BlackBrix/DIY-Reflow-Oven-w-Nextion/README.md

this project was 'forked' / copied from here:  
https://www.instructables.com/DIY-REFLOW-OVEN/  
  
created by 'Vulcaman' (© Christian Rostek)  
https://www.instructables.com/member/Vulcaman/  
www.vulcaman.de (including online shop)   
https://www.instagram.com/vulcaman/  
  
find more about Nextion intelligent HMI displays: https://nextion.tech  

see as well this forked project: -> https://github.com/polihedron/DIY-Reflow-Oven  
  
provided as 'open source' under the creative commons license:  
'Attribution-NonCommercial-ShareAlike 4.0 International (CC BY-NC-SA 4.0)'  
  

# non-commercial use !  
    
Original text as follows:

----

# DIY Reflow Oven

<p>

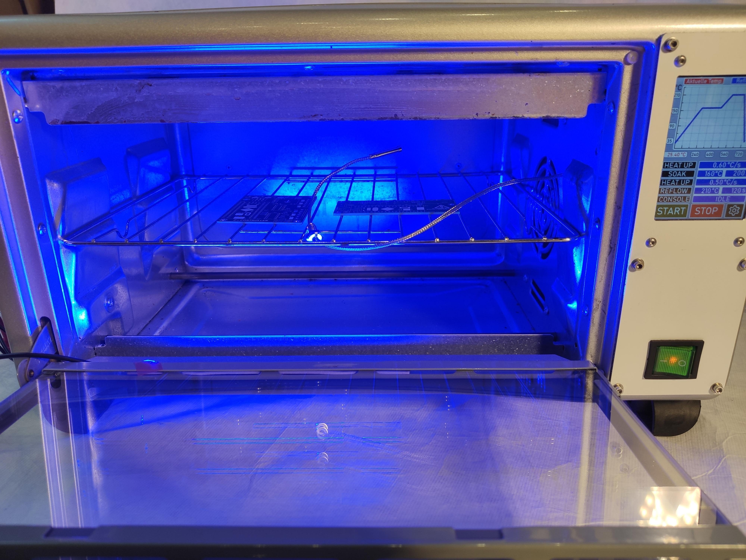
[picture p1: pics/reflow_2.jpg]

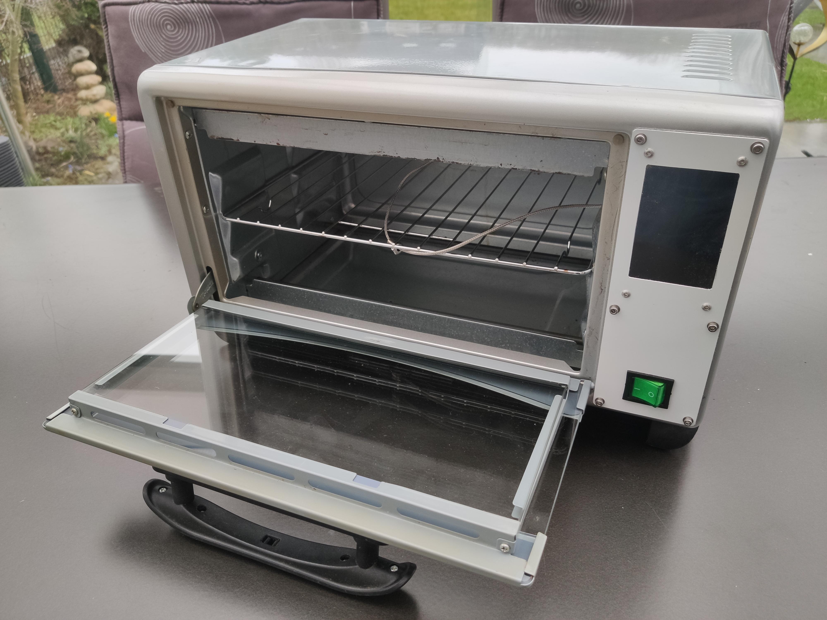
[picture p2: pics/reflow_3.jpg]

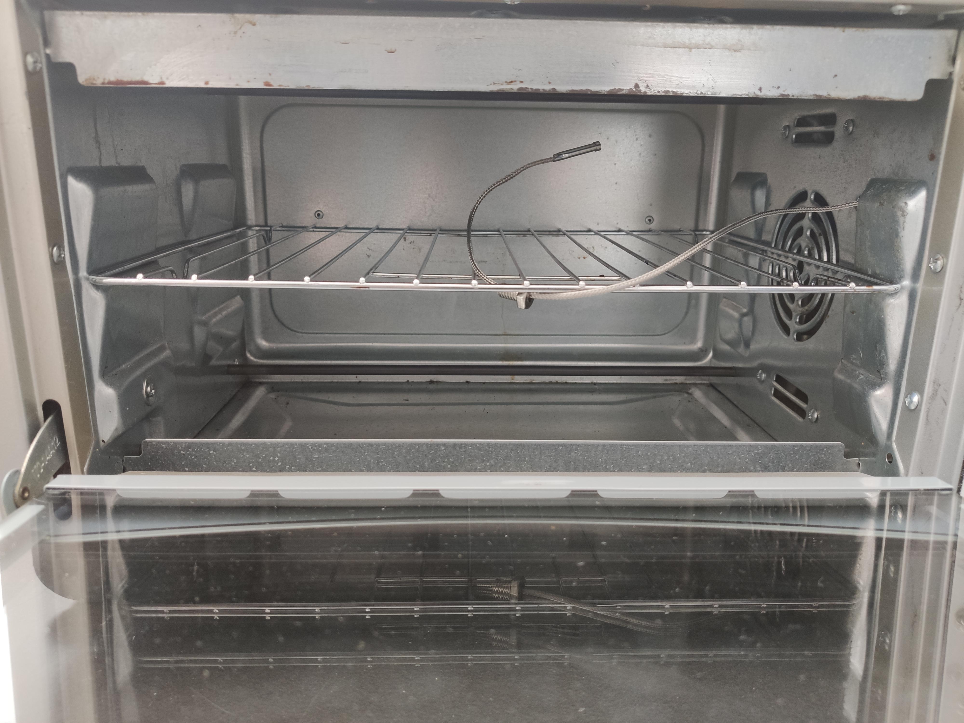
[picture p3: pics/reflow_4.jpg]

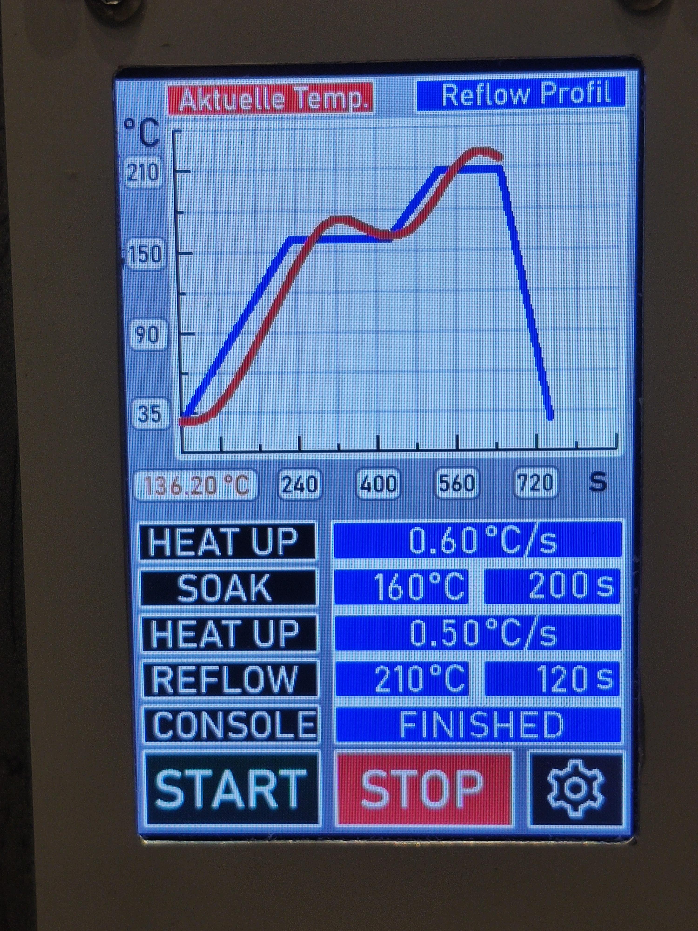
[picture p4: pics/reflow_5.jpg]


</p>

----

<div class="step-body"><p>In this Instructable I want to show you how you can build your own SMD Reflow Oven for under 60€.</p><p>For a few month now, I decided to getting deeper in electronics und PCB-Design. However many SMD components you can buy are so tiny that they are really hard to solder. In the Industry, the standart is an Oven with a predefined Temperature Curve, a so called Reflow-Oven. However a Industrial grade Reflow Oven is really Expensive, so I have searched the Web and I saw a lot of People converting an old Pizza-Oven to a Reflow-Oven. Sadly I couldn't find one which will look that professional I would like. So I started to build my own reflow oven and decided to make it Open Source :-)</p><p>The reflow oven has the followings features:</p><ul><li>1200 W of Power </li><li>Touch Screen </li><li>Modern GUI with Temperature Curve, Keypad and Parameters </li><li>Permanent storage of the settings (Stored in Flash) </li><li>STM32 Microcontroller (Blue Pill) </li><li>PID Temperature Controller </li><li>Overall Cost +-60€</li></ul>

<p><u><strong>Videos of the Reflow Oven<br></strong></u></p>
<ul><li>https://youtu.be/BAKA0E_wQRk</li>
<li>https://youtu.be/CvY7zXQO4RU</li></ul>

<p>If you like my Instructable, please vote for me in the <a href="https://www.instructables.com/contest/automation2021/">Automation Contest</a></p><p>Visit my <a href="https://www.instagram.com/vulcaman/" rel="nofollow noopener">Instagram</a></p><p>Visit my <a href="https://www.vulcaman.de/" rel="nofollow noopener">Website<br></a></p>

<p><strong><u>UPDATE:<br></u></strong></p><p><strong>[27.03.2021] (V1.1) Fixed Integral Wind-Up in PID Controller, Actual Temp will draw longer now<br></strong></p><p><strong>--&gt; Updated STM32 Source Files</strong><br></p></div>

---

## Step 1: Required Parts

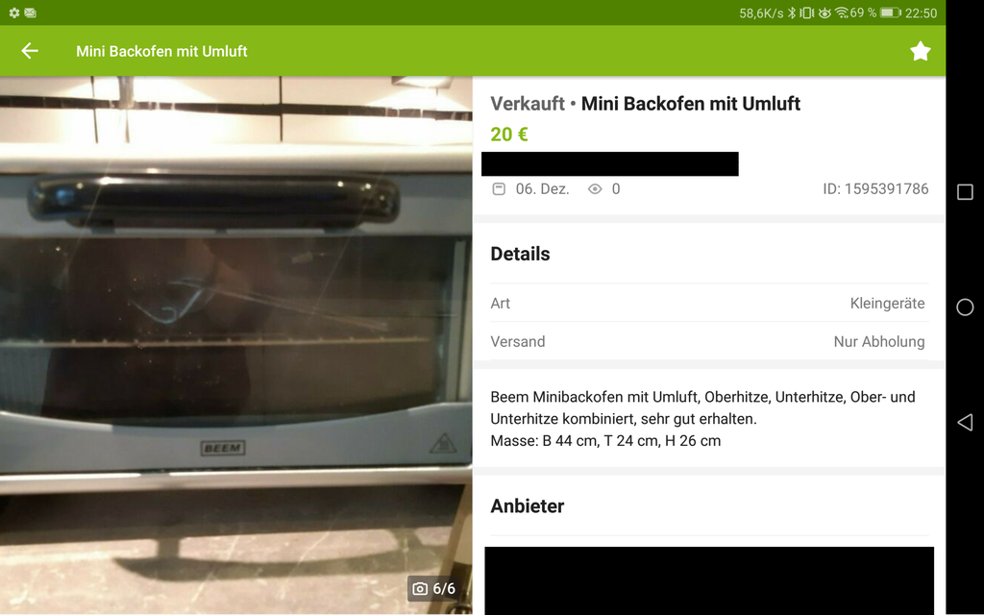
[picture p5: pics/Step_1_1.webp]
<div class="step-body"><p><strong><u>The Base<br></u></strong></p><p>For base the of the reflow oven you will need a cheap Pizza Oven, the more power, the better is oven is suited for an reflow oven, also an integrated ventilator is a plus point. I have found a used one on Ebay Kleinanzeigen for 20€ in my neighborhood which fits perfectly: </p><p></p><p>¨NBSP;</p><p><strong><u>Electronic Parts:<br></u></strong></p><p>Here are all the requierd components, for the reflow oven</p><table style="width: 100.0%;" border="2"><tbody><tr><th>Quantity</th><th>Description</th><th>Link</th><th>Price</th></tr><tr><td>1x</td><td>Nextion Display 3.5" Basic Version<br></td><td><a href="https://de.aliexpress.com/item/4001240732911.html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,searchweb201602_,searchweb201603_" rel="nofollow noopener">Aliexpress</a></td><td>25,32 €<br></td></tr><tr><td>1x</td><td>STM32F103C8T6 "Blue Pill"<br></td><td><a href="https://s.click.aliexpress.com/e/_AfFGsk" rel="nofollow noopener">Aliexpress</a></td><td>2,75 €</td></tr><tr><td>1x</td><td>MAX6675 Thermocouple Modul<br></td><td><a href="https://s.click.aliexpress.com/e/_ApxobS" rel="nofollow noopener">Aliexpress</a></td><td>2,28 €<br></td></tr><tr><td>1x</td><td>Level-Shifter 3.3V to 5V<br></td><td><a href="https://s.click.aliexpress.com/e/_AFqBnW" rel="nofollow noopener">Aliexpress</a></td><td>3,01€ for 10pcs<br></td></tr><tr><td>1x</td><td>5V Powersupply <br></td><td><a href="https://s.click.aliexpress.com/e/_AUP3rQ" rel="nofollow noopener">Aliexpress</a></td><td>1,40€<br></td></tr><tr><td>1x</td><td>SSR Relay 25A<br></td><td><a href="https://s.click.aliexpress.com/e/_ABwoOg" rel="nofollow noopener">Aliexpress</a></td><td>2,93€ <br></td></tr><tr><td>1x</td><td>Main Switch Green<br></td><td><a href="https://s.click.aliexpress.com/e/_9vae84" rel="nofollow noopener">Aliexpress</a></td><td>0,9€<br></td></tr><tr><td>some</td><td>Terminals and Pinheaders<br></td><td><br></td><td><br></td></tr><tr><td>some</td><td>Wires<br></td><td><br></td><td><br></td></tr></tbody></table><p><strong><u><br></u></strong></p><p><strong><u>Mechanical Parts:<br></u></strong></p><p>You will need some screws to mount the display and the front panel<strong><u><br></u></strong></p><table style="width: 100.0%;" border="2"><tbody><tr><th>Quantity</th><th>Description</th><th>Link<br></th></tr><tr><td>10x</td><td><p>M3x16mm DIN912 </p></td><td>local hardware store<br></td></tr><tr><td>some</td><td><p>M3 Hex Nut </p></td><td>local hardware store<br></td></tr><tr><td>1x</td><td><p>Sheet of Alu-Dibond / Aluminium for the Frontpanel</p></td><td>local hardware store<br></td></tr></tbody></table><p><strong><u><br></u></strong></p></div>

---

## Step 2: Remove All the Electronics From the Oven

<p>
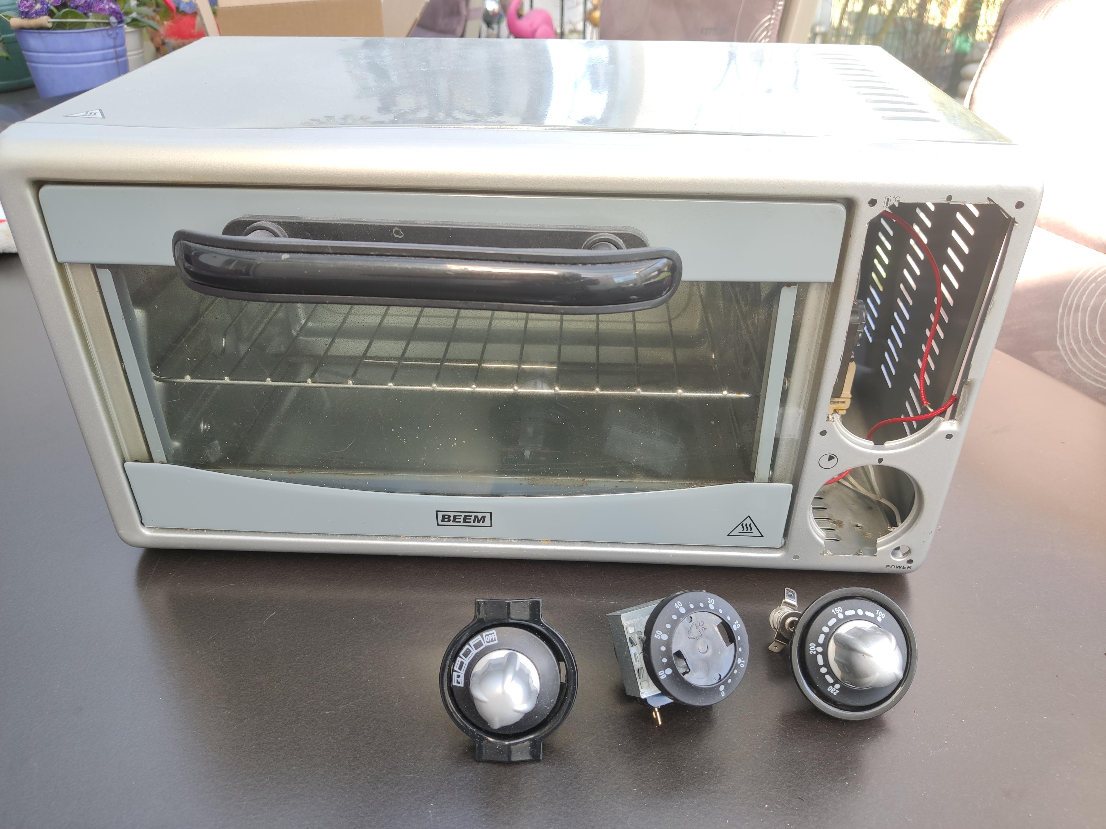
[picture p6: pics/Step2_1.jpg]

</p>

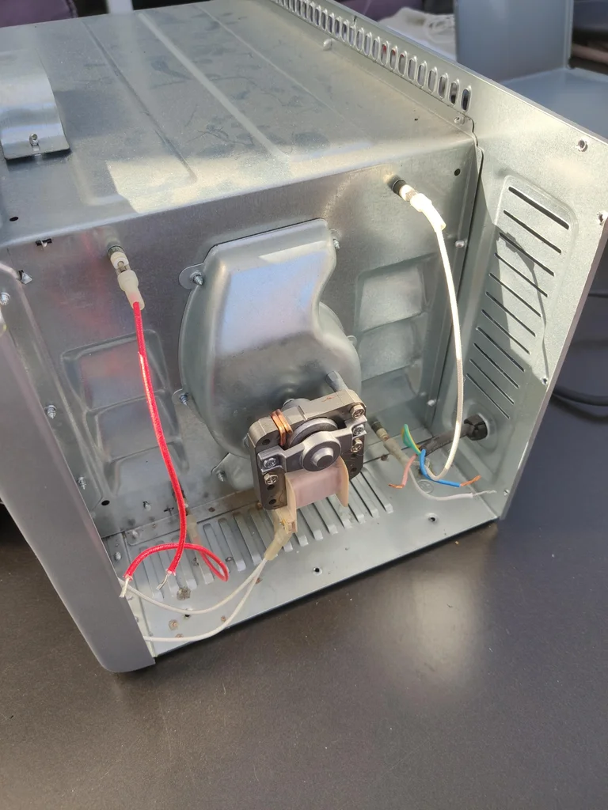
[picture p7: pics/Step2_2.webp]
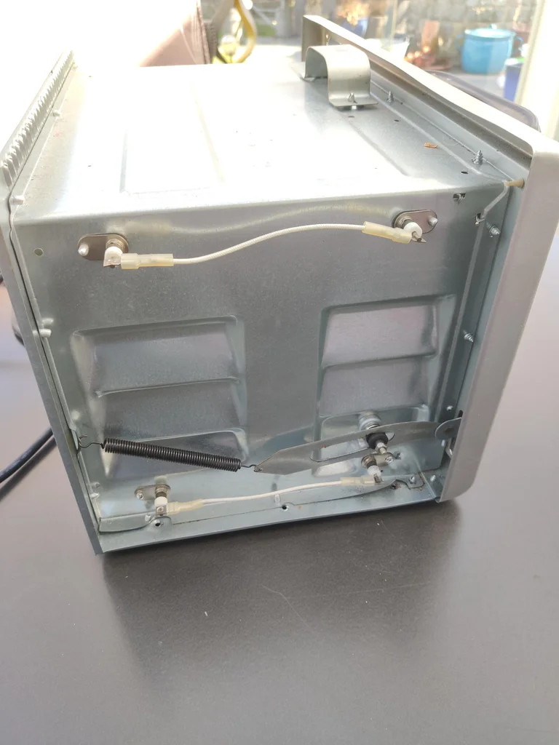
[picture p8: pics/Step2_3.webp]
<div class="step-body"><p>At first you will need to remove everything of the old electronics from the oven. Take care about the sharp edges from the sheet metal!</p><p></p></div>

---

## Step 3: Attach the Main Switch and the Nextion Display to the Frontpanel

<p>
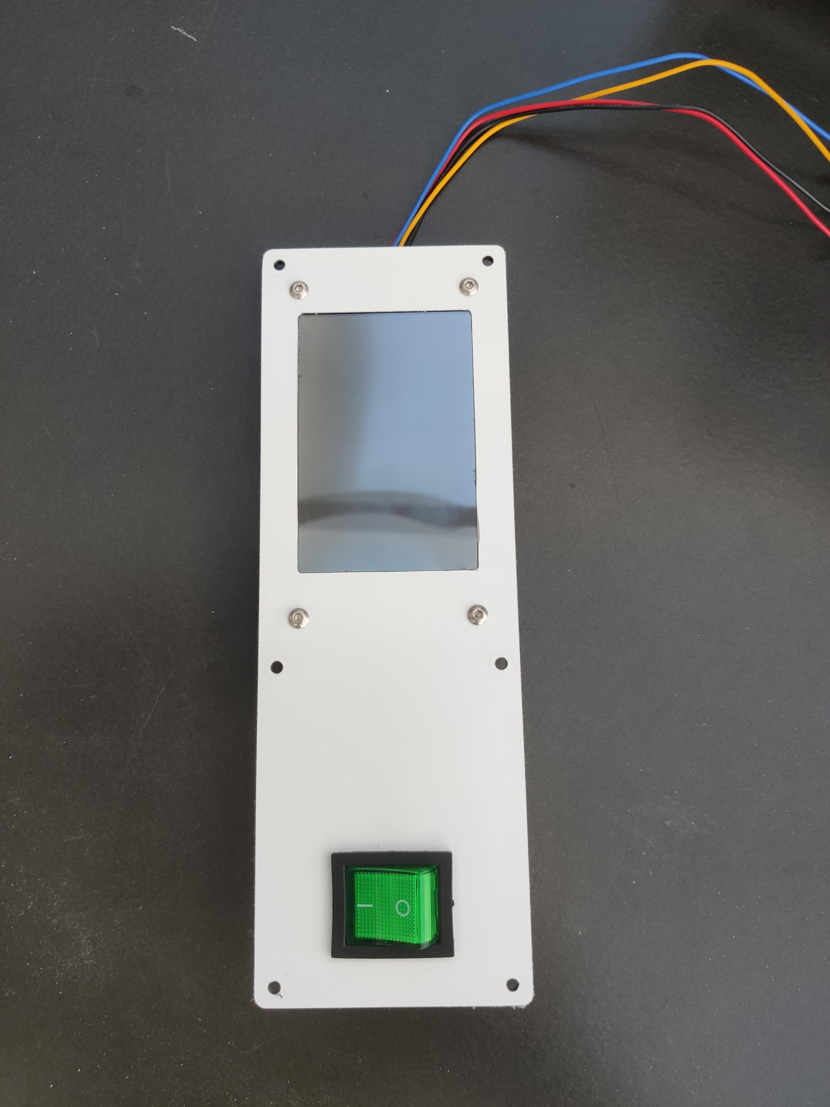
[picture p9: pics/Step3_1.jpg]

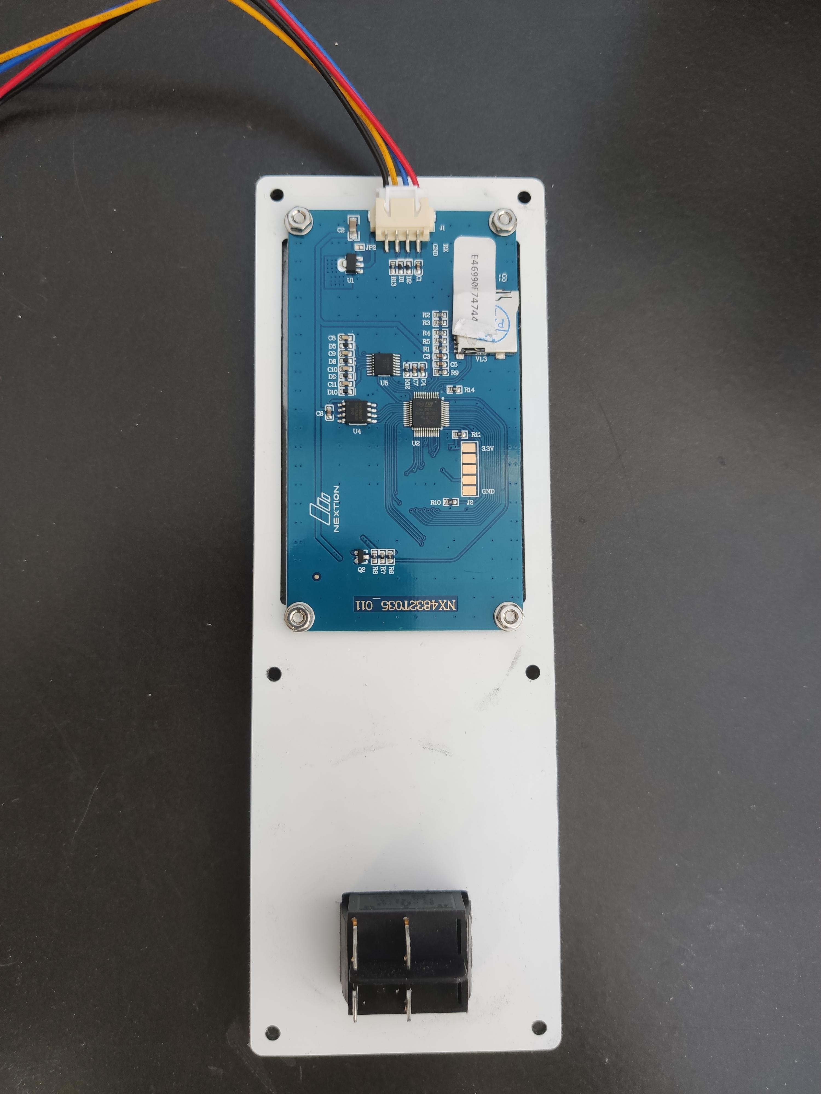
[picture p10: pics/Step3_2.jpg]

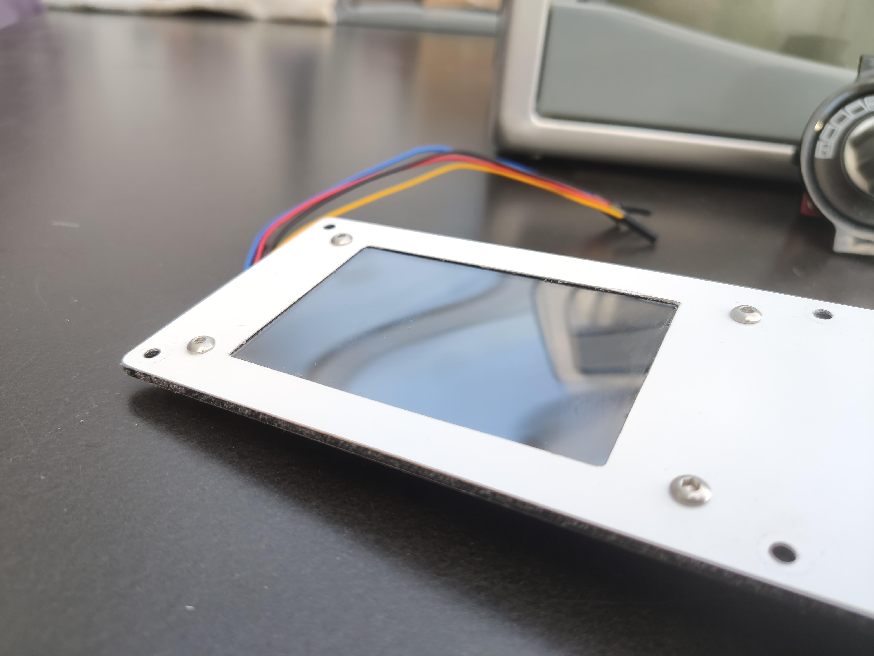
[picture p11: pics/Step3_3.jpg]

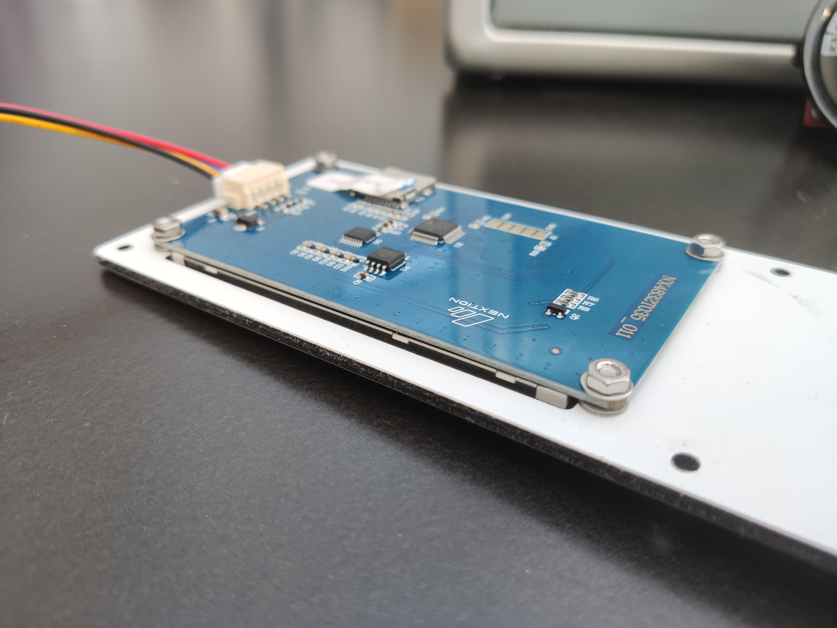
[picture p12: pics/Step3_4.jpg]

</p>

<div class="step-body"><p>I wanted a clean look of the reflow oven. No cables, no sharp edges, a oven which can be used as a tool.</p><p>So I have milled a front panel out of aluminum dibond, where I have placed the nextion display and a power switch</p></div>

---

## Step 4: Build the Electronics

<p>
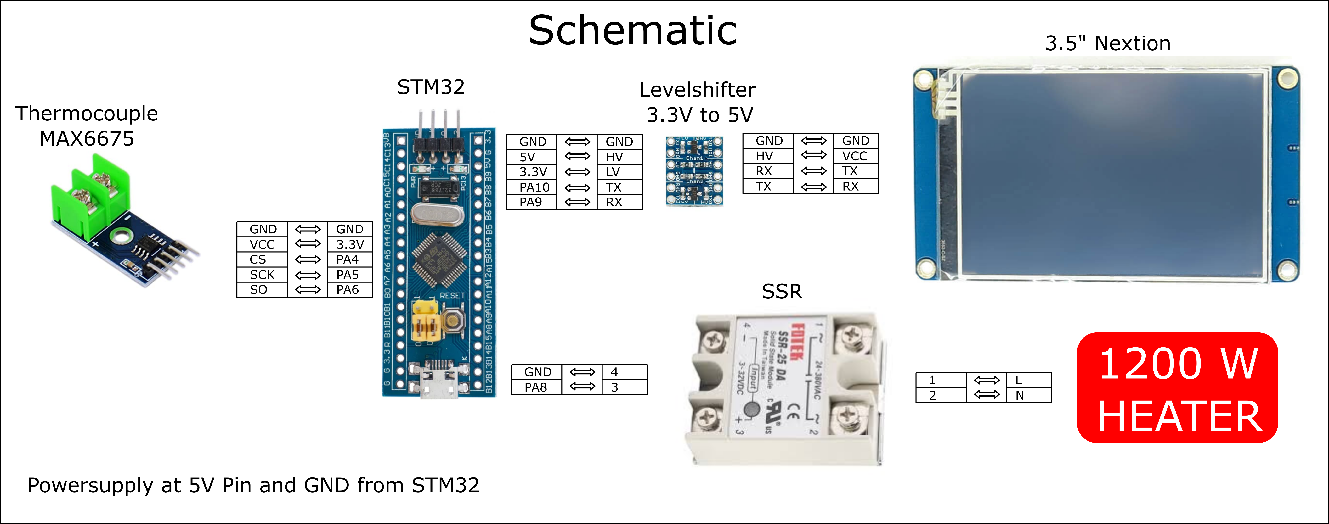
[picture p13: pics/Step4_1.png]

</p>

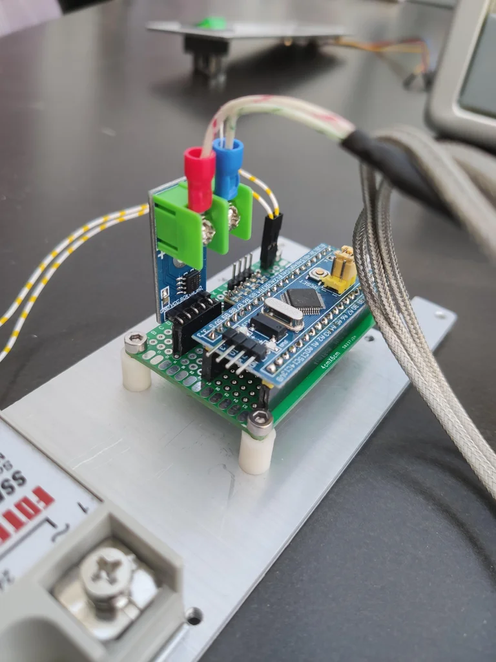
[picture p14: pics/Step4_2.webp]
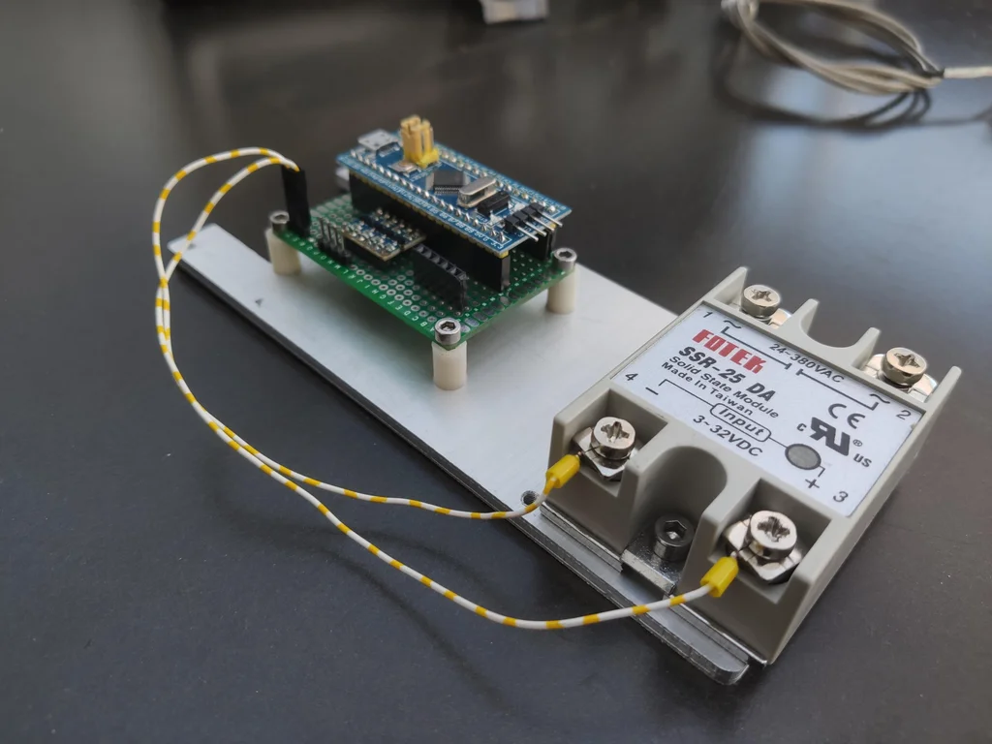
[picture p15: pics/Step4_3.webp]
<div class="step-body"><p>The electronics of the reflow oven is really simple. It is just a STM32 Bluepill board, with a MAX6675 thermocouple module, a Nextion 3.5" display and a solid state relay. You will find the schematic above. The level shifter in front of the nextion display is required, beacuse the STM32 works with 3.3V and the Nextion with 5V. I have mounted the electronics on a 3mm Aluminum sheet. </p><p></p></div>

---

## Step 5: Attach the Display to the Case

<p>
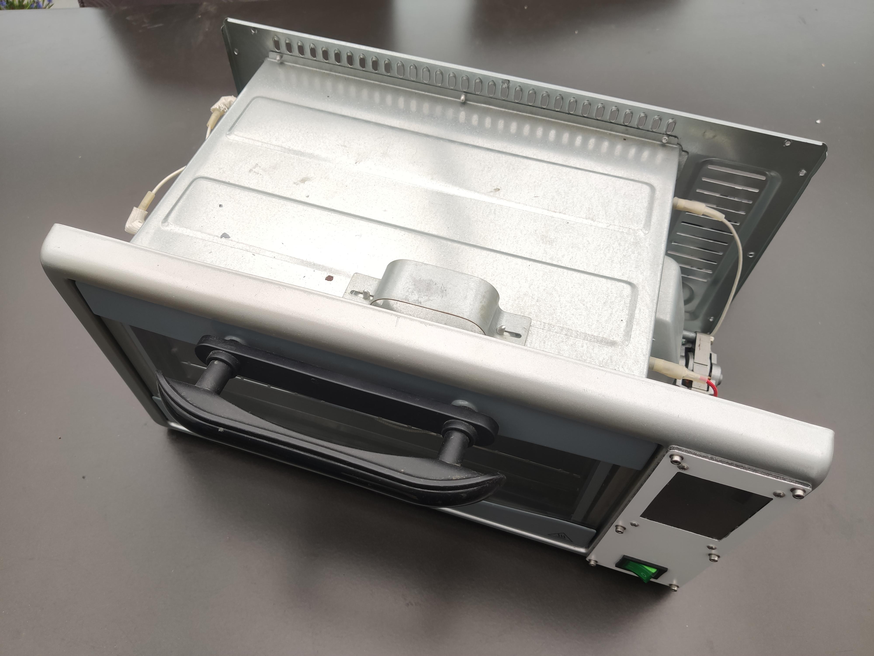
[picture p16: pics/Step5_1.jpg]

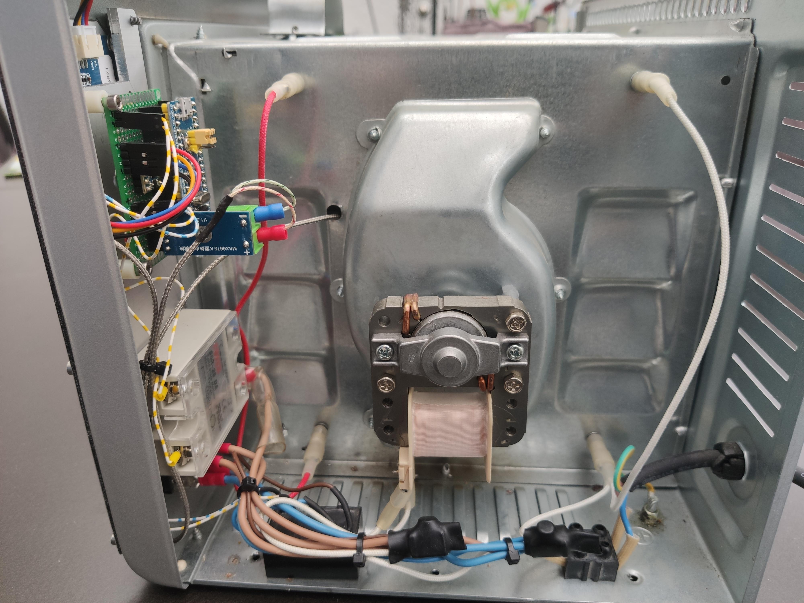
[picture p17: pics/Step5_2.jpg]

</p>

<div class="step-body"><p>Now it's time to put the electronics back to the oven. Try to wire everything as nice as possible. However take a lot of care, because you will work with Main Voltage (230 V) which can potentially kill you!!!</p></div>

---

## Step 6: Isolate It

<p>
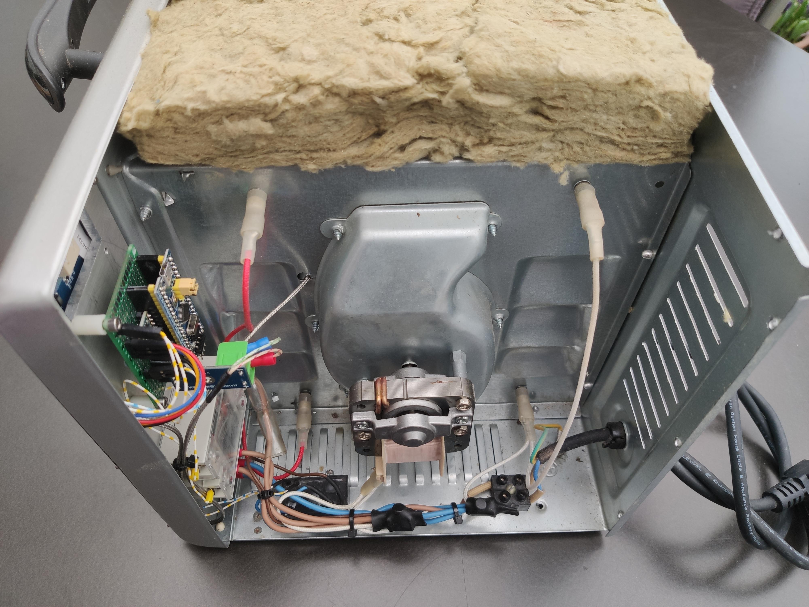
[picture p18: pics/Step6_1.jpg]

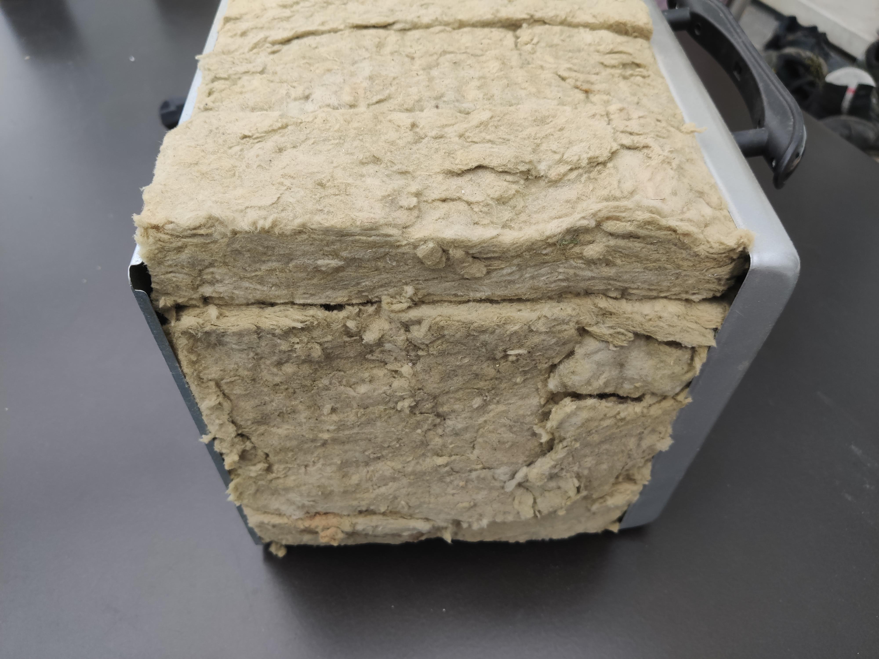
[picture p19: pics/Step6_2.jpg]

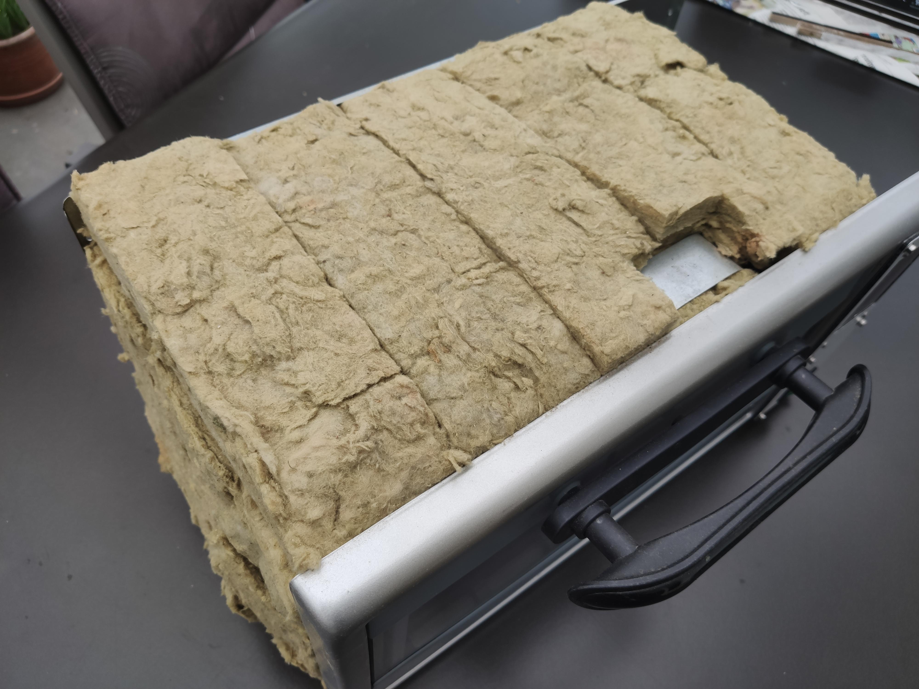
[picture p20: pics/Step6_3.jpg]

</p>

<div class="step-body"><p>For a better heat management, I have put some Rock Wool between the heating chamber and the outside of the oven. This way I could achieve that the oven only gets hand-warm on the outside of the oven.</p></div>

---

## Step 7: Put the Original Enclosure Back on the Oven

<p>
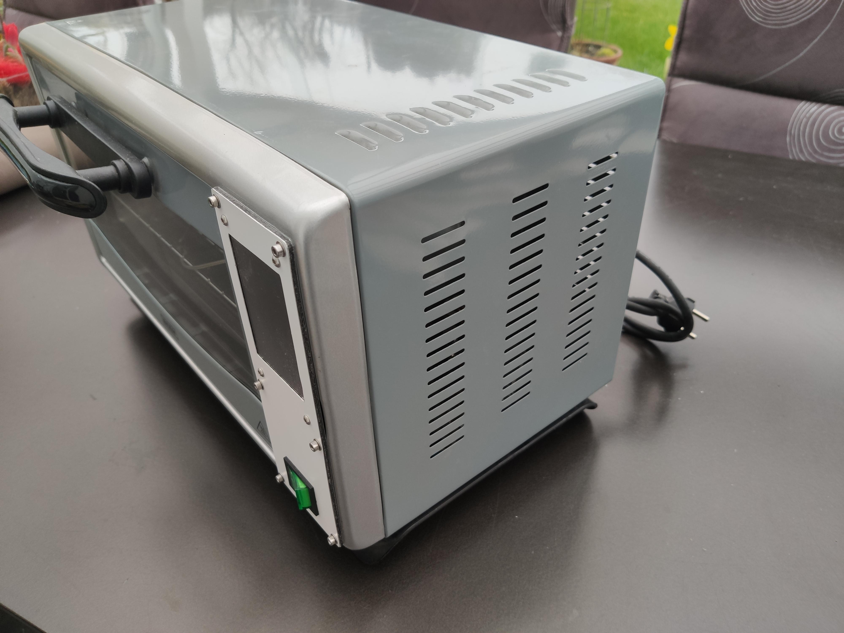
[picture p21: pics/Step7_1.jpg]

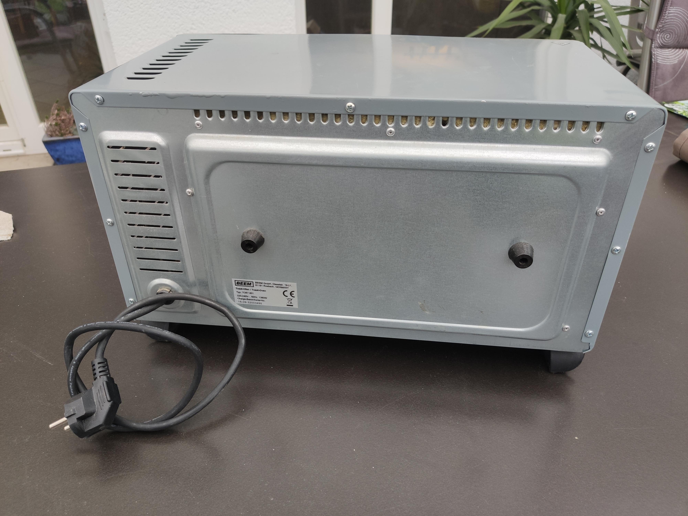
[picture p22: pics/Step7_2.jpg]


</p>

---

## Step 8: Programm the Nextion Display

<p>

</p>

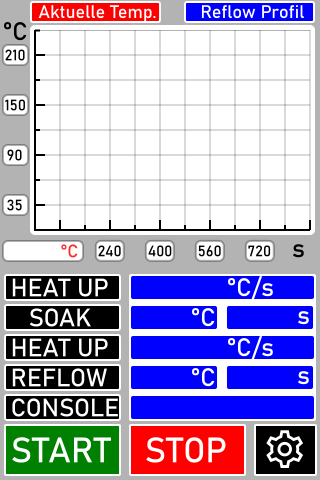
[picture p23: pics/Step8_2.webp]
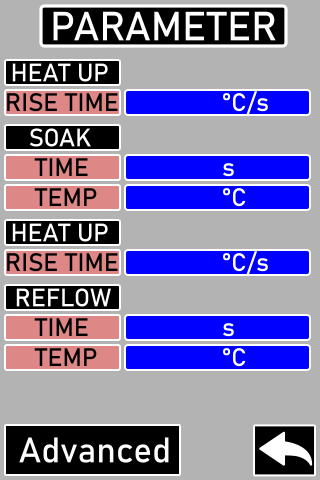
[picture p24: pics/Step8_3.webp]
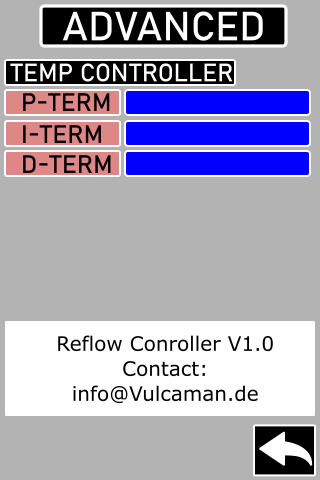
[picture p25: pics/Step8_4.webp]
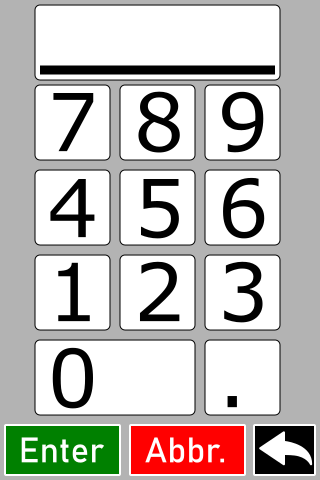
[picture p26: pics/Step8_5.webp]
<div class="step-body"><p>For the User Interface, I have designed my own GUI in the Nextion Editor. The GUI consist of four pages, which are shown below:</p><p>The first Page shows all the necessary Information which are important for the Reflow Soldering</p><p></p><p> If you press on the Settings Button, you will be forwarded to the Parameters Page. There you can define all the Settings for the Profile</p><p></p><p>If you press on Advanced, you will be forwarded to the Advanced Settings, where you can adjust the PID-Parameters for the Heater</p><p></p><p>The Last Page is the KeyPad. The KeyPad will be opened when you press on the red Button of the Parameters</p><p></p><p>For a better explenation of the GUI, please watch the Youtube Video from the Beginning</p><p>##########################################################################</p><p><u><strong>Flash the Nextion Display<br></strong></u></p><p>To Flash the Nextion Display, you have to download the <a href="https://nextion.tech/nextion-editor/" rel="nofollow noopener">Nextion Editor</a>.</p><p>Then you just open the .HMI File and upload it to the Display </p></div>
  
HMI-File: https://github.com/BlackBrix/DIY-Reflow-Oven-w-Nextion/raw/main/Nextion_HMI/Reflow.HMI
  
---

## Step 9: Programm the STM32 + Source Code

<p>
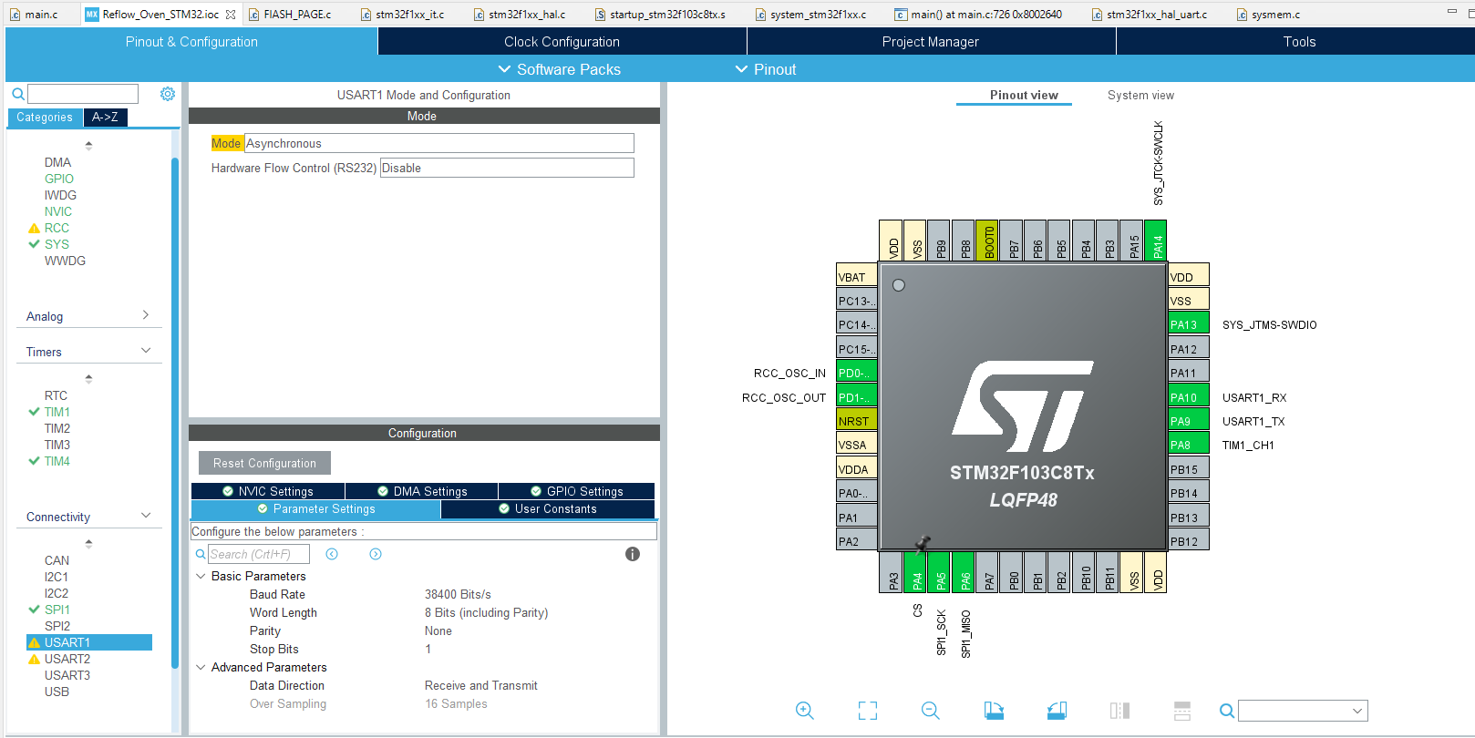
[picture p27: pics/Step9_1.png]

</p>

<div class="step-body"><p>For this Project, I have used a STM32F103C8T6 Microcontroller, which I have programmed with CUBEMX and STM32CubeIDE. The STM32 will handle the complete control of the Oven. However there are some important things you should know.</p><p><br><u>The GPIO Pin for the Relay<br></u></p><p>To adjust the Output Power of the Heater I have used a Solid State Relay. While working with SSR Relays, you should know that they are often build with Triacs as switching Unit. This means that the SSR can only switch off when the Current is zero. The Heater is Controlled by 230 V 50 Hz Main Voltage so I have to switch way slower than 50 Hz for an better power control. So have set the PWM Frequecy on Pin PA9 to 1 Hz. That way, I could simply adjust the power by the dutycycle on Pin PA9.<u><br></u></p><p><u>The PID Controller<br></u></p><p>For the PID-Controller I have used the PID Implementation from the ARM CMSIS Package. You can find the documentation <a href="https://www.keil.com/pack/doc/CMSIS/DSP/html/group__PID.html" rel="nofollow noopener">here<br></a></p><p><u>Write of the parameters to the Flash Memory<br></u></p><p>To store the parameters permanently to the STM32, the parameters will be automatically stored to the Flash Memory of the STM32. Here I have used the Flash library from <a href="https://www.youtube.com/watch?v=BKgh896Bj8Q" rel="nofollow noopener">Controllers Tech<br></a></p><p>##############################################################</p><p><u><strong>Flash the STM32<br></strong></u></p><p>Because it much more complicated to set up the STM32CUBEIde and include all the libraries compared to the Arduino IDE, I have precompiled the C-Code as a .bin file. So all you have to do is to flash the .bin file with the <a href="https://www.st.com/en/development-tools/stsw-link004.html" rel="nofollow noopener">ST-Link-Utility</a> to the STM32. For flashing the STM32 you will need a ST-Link Programmer</p><p>You can download all the Source Files below:</p><p>Or download them from <a href="https://drive.google.com/drive/folders/1B09TK_5CR2aG5pWbvl-CoUNYtiuce62N?usp=sharing" rel="nofollow noopener">Google Drive</a></p><p><br></p><p><u><br></u></p></div>  

<strong>Downloads:</strong>  
<ul><li>source code (V1.0): https://github.com/BlackBrix/DIY-Reflow-Oven-w-Nextion/raw/main/downloads/Reflow_Oven_STM32_Source.zip</li>
<li>source code (V1.1): https://github.com/BlackBrix/DIY-Reflow-Oven-w-Nextion/raw/main/downloads/Reflow_Oven_STM32_SOURCE_V1_1.zip</li>
<li>compiled binaries (V1.0 & V1.1): https://github.com/BlackBrix/DIY-Reflow-Oven-w-Nextion/raw/main/downloads/Reflow_Oven_Bin_Files.zip</li>
<li>HMI-File: https://github.com/BlackBrix/DIY-Reflow-Oven-w-Nextion/raw/main/Nextion_HMI/Reflow.HMI</li></ul>  
    
---
  
## Step 10: Pictures From Soldering

<p>
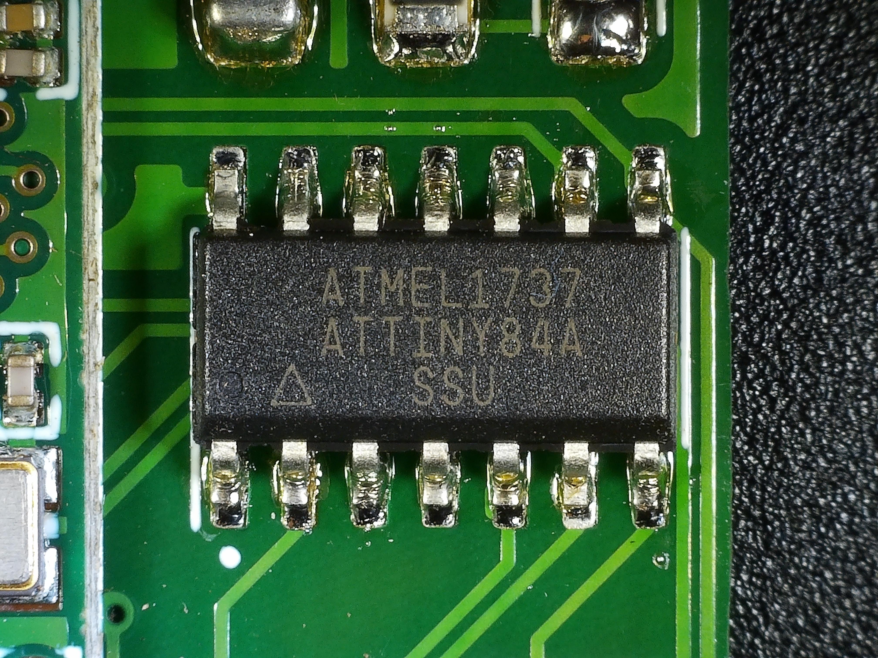
[picture p28: pics/Step10_1.jpg]

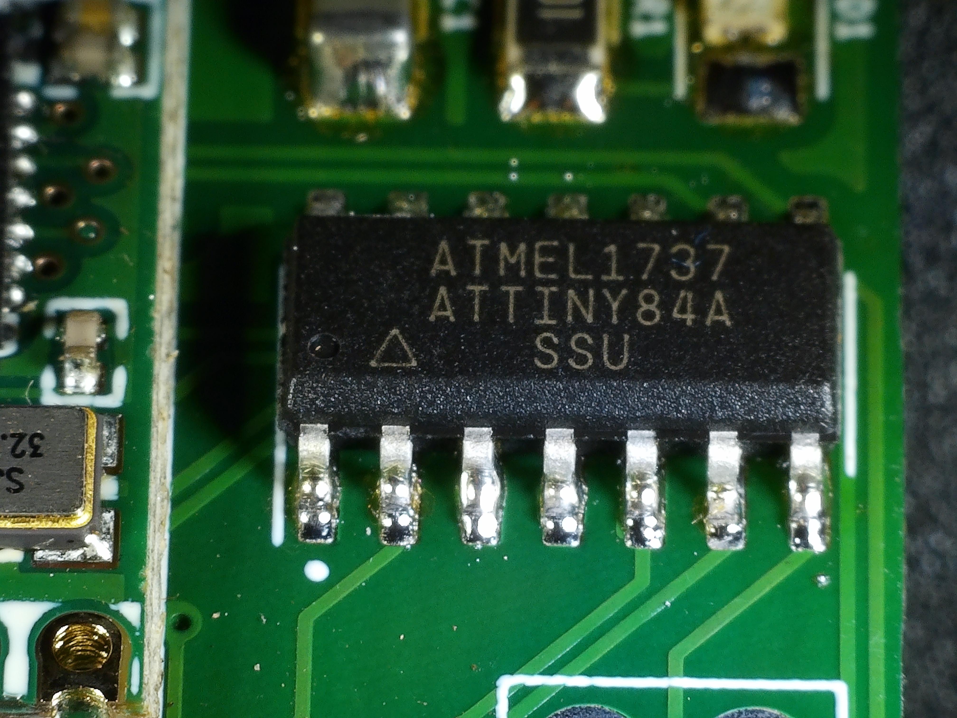
[picture p29: pics/Step10_2.jpg]

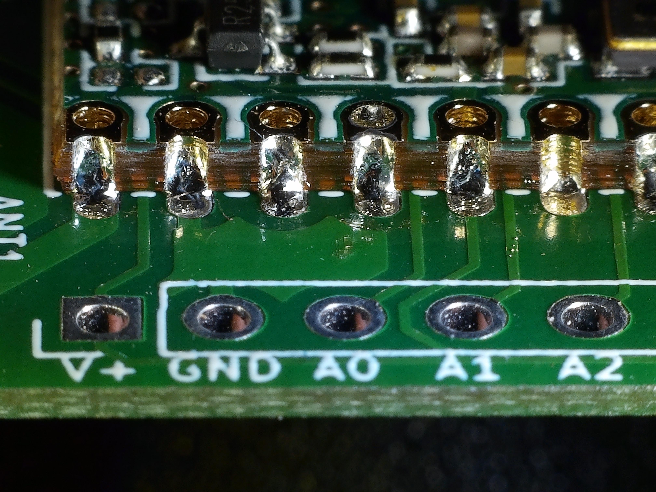
[picture p30: pics/Step10_3.jpg]

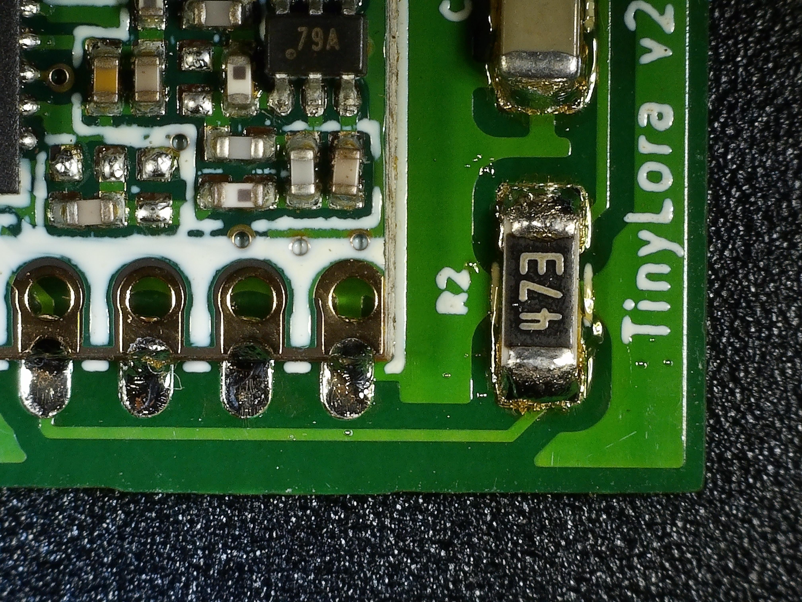
[picture p31: pics/Step10_4.jpg]

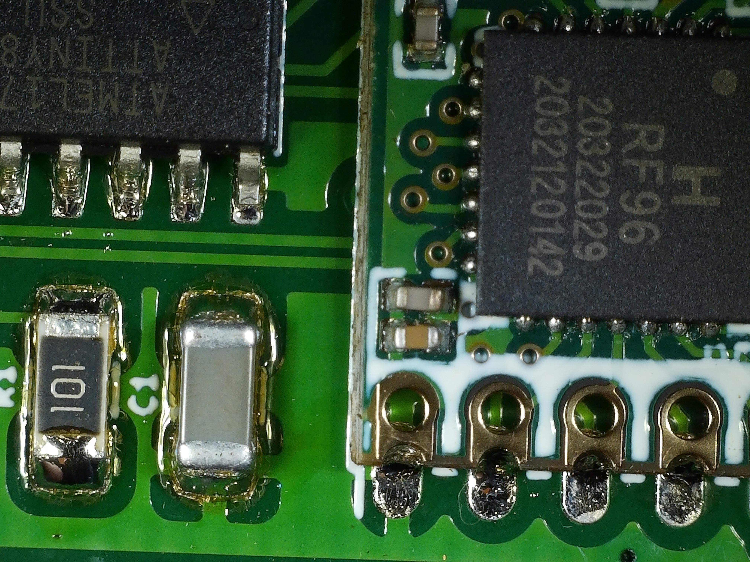
[picture p32: pics/Step10_5.jpg]

</p>

<div class="step-body"><p>Here you will see some results from soldering. As you can see the soldering is quite nice :-)</p><p>I have used Sn63Pb37 Solder Paste for this PCB. In the future I will update this step with some more PCBs which I have soldered. Also take a look at my <a href="https://www.instagram.com/vulcaman/" rel="nofollow noopener">Instagram</a> for more pictures.</p><p><u><strong>### If you have any questions, feel free to contact me ###<br></strong></u></p></div>

'Vulcaman' https://www.instructables.com/member/Vulcaman/  
www.vulcaman.de  
https://www.instagram.com/vulcaman/  

----

End of original text
